Roman-Rice-Engineering/Pen_plotter_V2/custom_test.txt

[gwrite.my_own_plotter]
unit = "mm"
document_start = "M3 G21\n"
layer_start = "(Start Layer)\n"
line_start = "(Start Block)\n"
segment_first = """G00 X{x:.4f}f Y{y:.4f}
M3 S150
G4 P0.5
"""
segment = """G01 X{x:.4f} Y{y:.4f} F2500\n"""
line_end = """M5 S0
G4 P0.5\n"""
document_end = """M5
G00 X0.0000 Y0.0000
M2"""
invert_y = true

# from home
.local/pipx/venvs/vpype/lib/python3.10/site-packages/vpype_gcode/bundled_configs.toml

install pdftocairo
RUN wget --directory-prefix=~ poppler.freedesktop.org/poppler-22.04.0.tar.xz -O /tmp/poppler-22.04.0.tar.xz && apt-get install xz-utils && tar xf /tmp/poppler-22.04.0.tar.xz -C /tmp && cd /tmp/poppler-22.04.0 && ls && mkdir build && cd build && apt-get -y install libfreetype6-dev && apt-get -y install pkg-config && apt-get -y install libfontconfig1-dev && apt-get -y install libjpeg-dev && apt-get -y install libopenjp2-7-dev && apt-get -y install build-essential cmake && cmake -DENABLE_BOOST=OFF .. && make && make install 
pdftocairo -v
