Roman-Rice-Engineering/Pen_plotter_V2/PCB/Pen_Plotter_RPI_Hat_V2/3D_Models/CSTLS8M00G56-A0.step

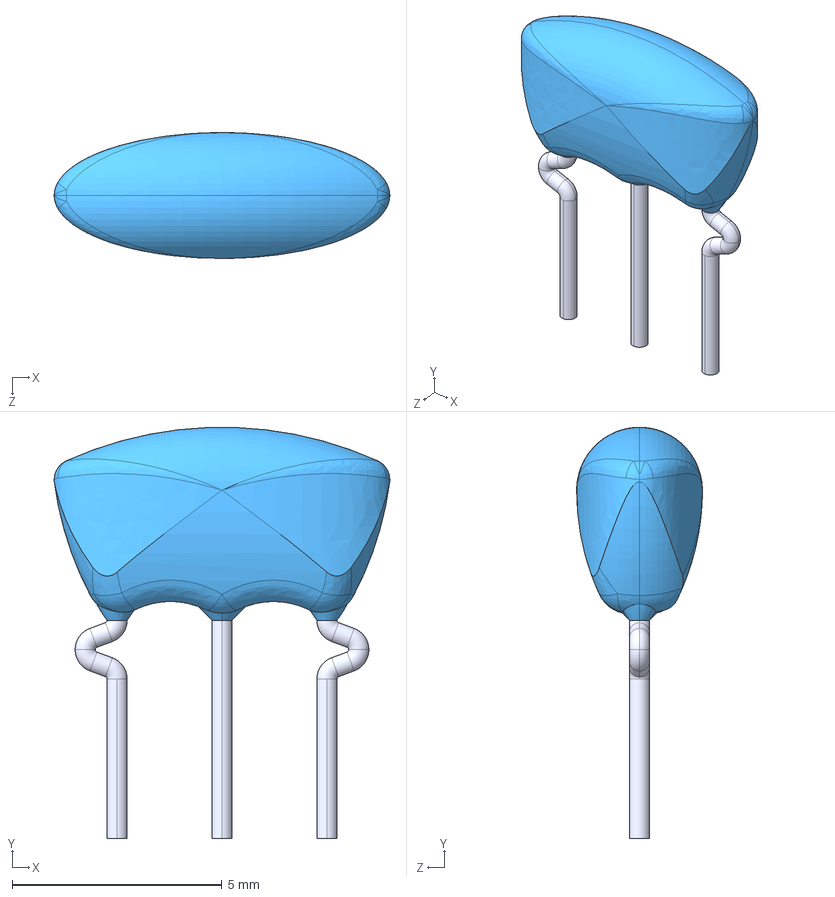
[picture p1: CAD file, 2024-05-06]
PCB/Pen_Plotter_RPI_Hat_V2/3D_Models/CSTLS8M00G56-A0.step
8.00 x 9.79 x 3.00 mm
