Roman-Rice-Engineering/Pen_plotter_V2/PCB/Pen_Plotter_RPI_Hat_V2/3D_Models/L-53GD--3DModel-STEP-510211.STEP

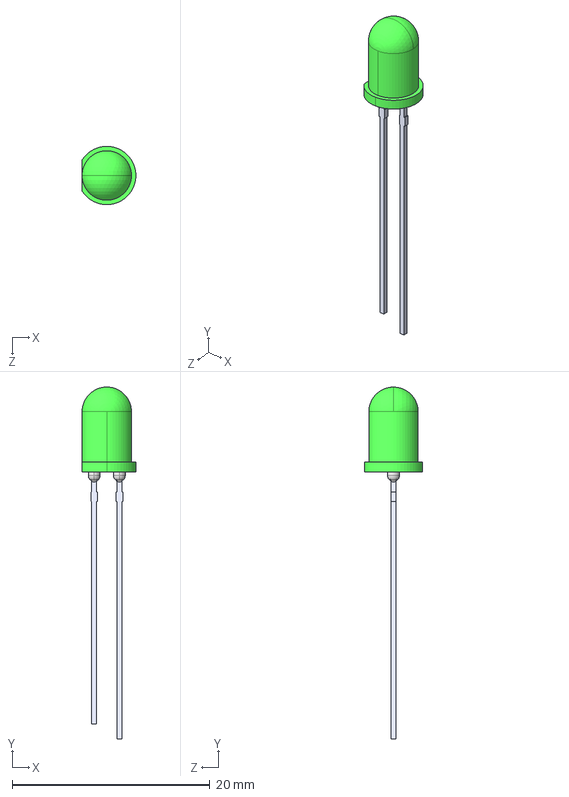
[picture p2: CAD file, 2024-01-29]
PCB/Pen_Plotter_RPI_Hat_V2/3D_Models/L-53GD--3DModel-STEP-510211.STEP
5.45 x 35.6 x 5.90 mm
