Roman-Rice-Engineering/Pen_plotter_V2/PCB/Pen_Plotter_RPI_Hat_V2/Pen_Plotter_RPI_Hat_V2.kicad_pcb

## KiCad design PCB/Pen_Plotter_RPI_Hat_V2/Pen_Plotter_RPI_Hat_V2.kicad_pcb (2024-05-07)

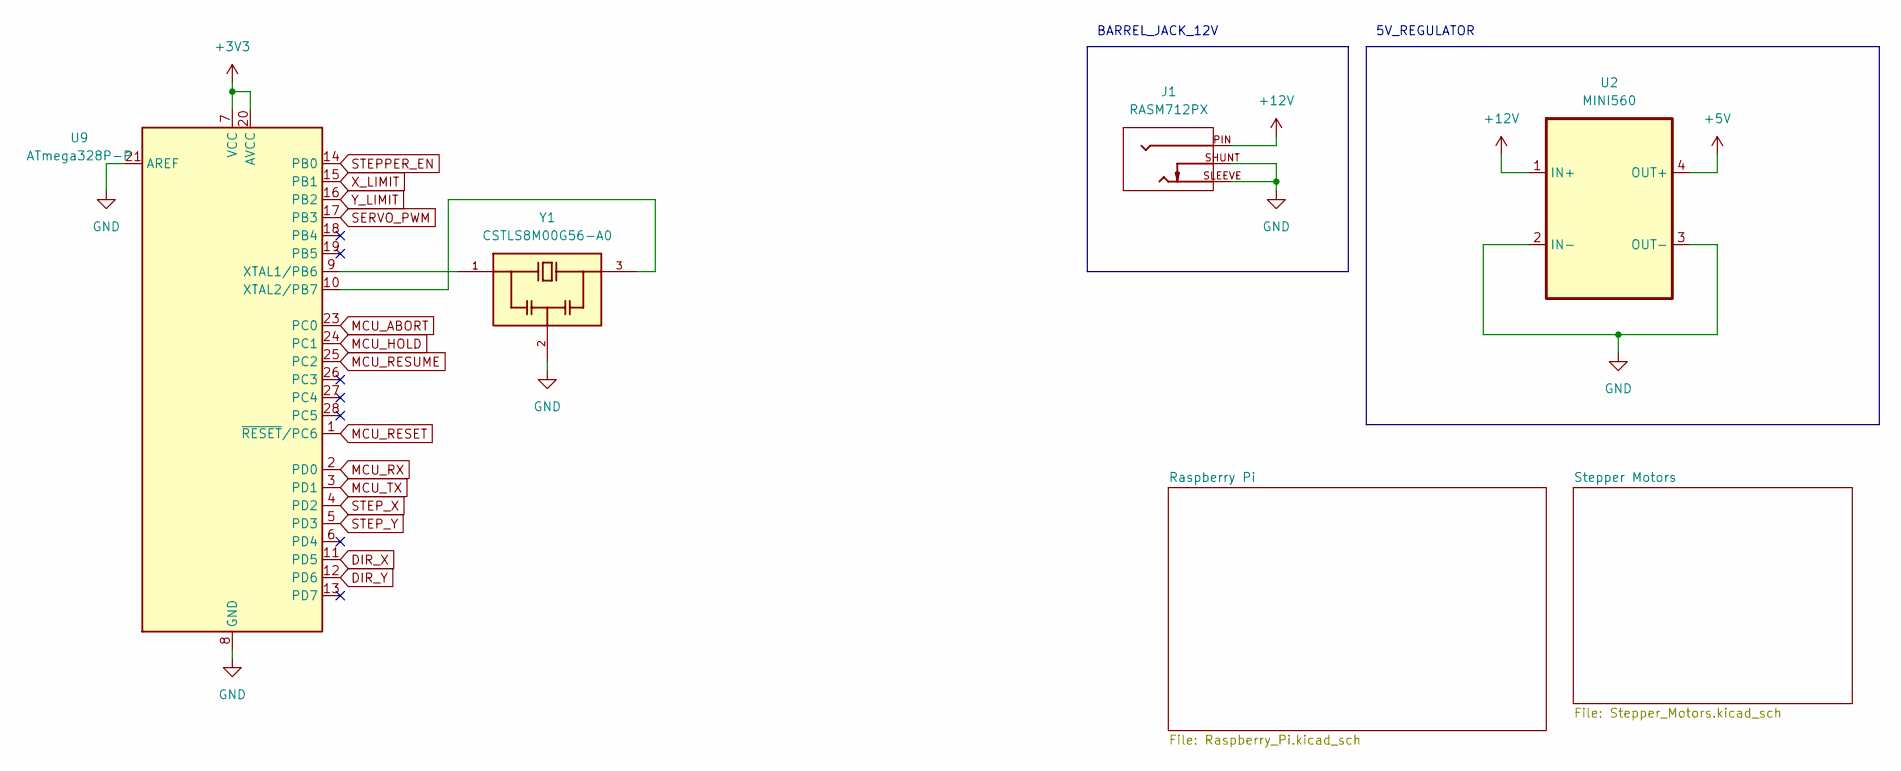
[picture p3: schematic Pen_Plotter_RPI_Hat_V2.kicad_sch]

Parts:
J1: RASM712PX; SWITCHCRAFT_RASM712PX; PARTREV A
U2: MINI560; MINI560_5V
U9: ATmega328P-P; DIP-28_W7.62mm
Y1: CSTLS8M00G56-A0; OSC_CSTLS8M00G56-A0; PARTREV March 23, 2017

Connections:
+3V3: U9.7 (VCC), U9.20 (AVCC); also elsewhere on the board
+5V: U2.4 (OUT+); also elsewhere on the board
+12V: J1.PIN, U2.1 (IN+); also elsewhere on the board
DIR_X: U9.11 (PD5); also elsewhere on the board
DIR_Y: U9.12 (PD6); also elsewhere on the board
GND: J1.SHUNT, J1.SLEEVE, U2.2 (IN-), U2.3 (OUT-), U9.8 (GND), U9.21 (AREF), U9.22 (GND), Y1.2; also elsewhere on the board
MCU_ABORT: U9.23 (PC0); also elsewhere on the board
MCU_HOLD: U9.24 (PC1); also elsewhere on the board
MCU_RESET: U9.1 (~RESET/PC6); also elsewhere on the board
MCU_RESUME: U9.25 (PC2); also elsewhere on the board
MCU_RX: U9.2 (PD0); also elsewhere on the board
MCU_TX: U9.3 (PD1); also elsewhere on the board
unnamed: U9.9 (XTAL1/PB6), Y1.1
unnamed: U9.10 (XTAL2/PB7), Y1.3
SERVO_PWM: U9.17 (PB3); also elsewhere on the board
STEPPER_EN: U9.14 (PB0); also elsewhere on the board
STEP_X: U9.4 (PD2); also elsewhere on the board
STEP_Y: U9.5 (PD3); also elsewhere on the board
X_LIMIT: U9.15 (PB1); also elsewhere on the board
Y_LIMIT: U9.16 (PB2); also elsewhere on the board

Notes on the sheet:
5V_REGULATOR
BARREL_JACK_12V

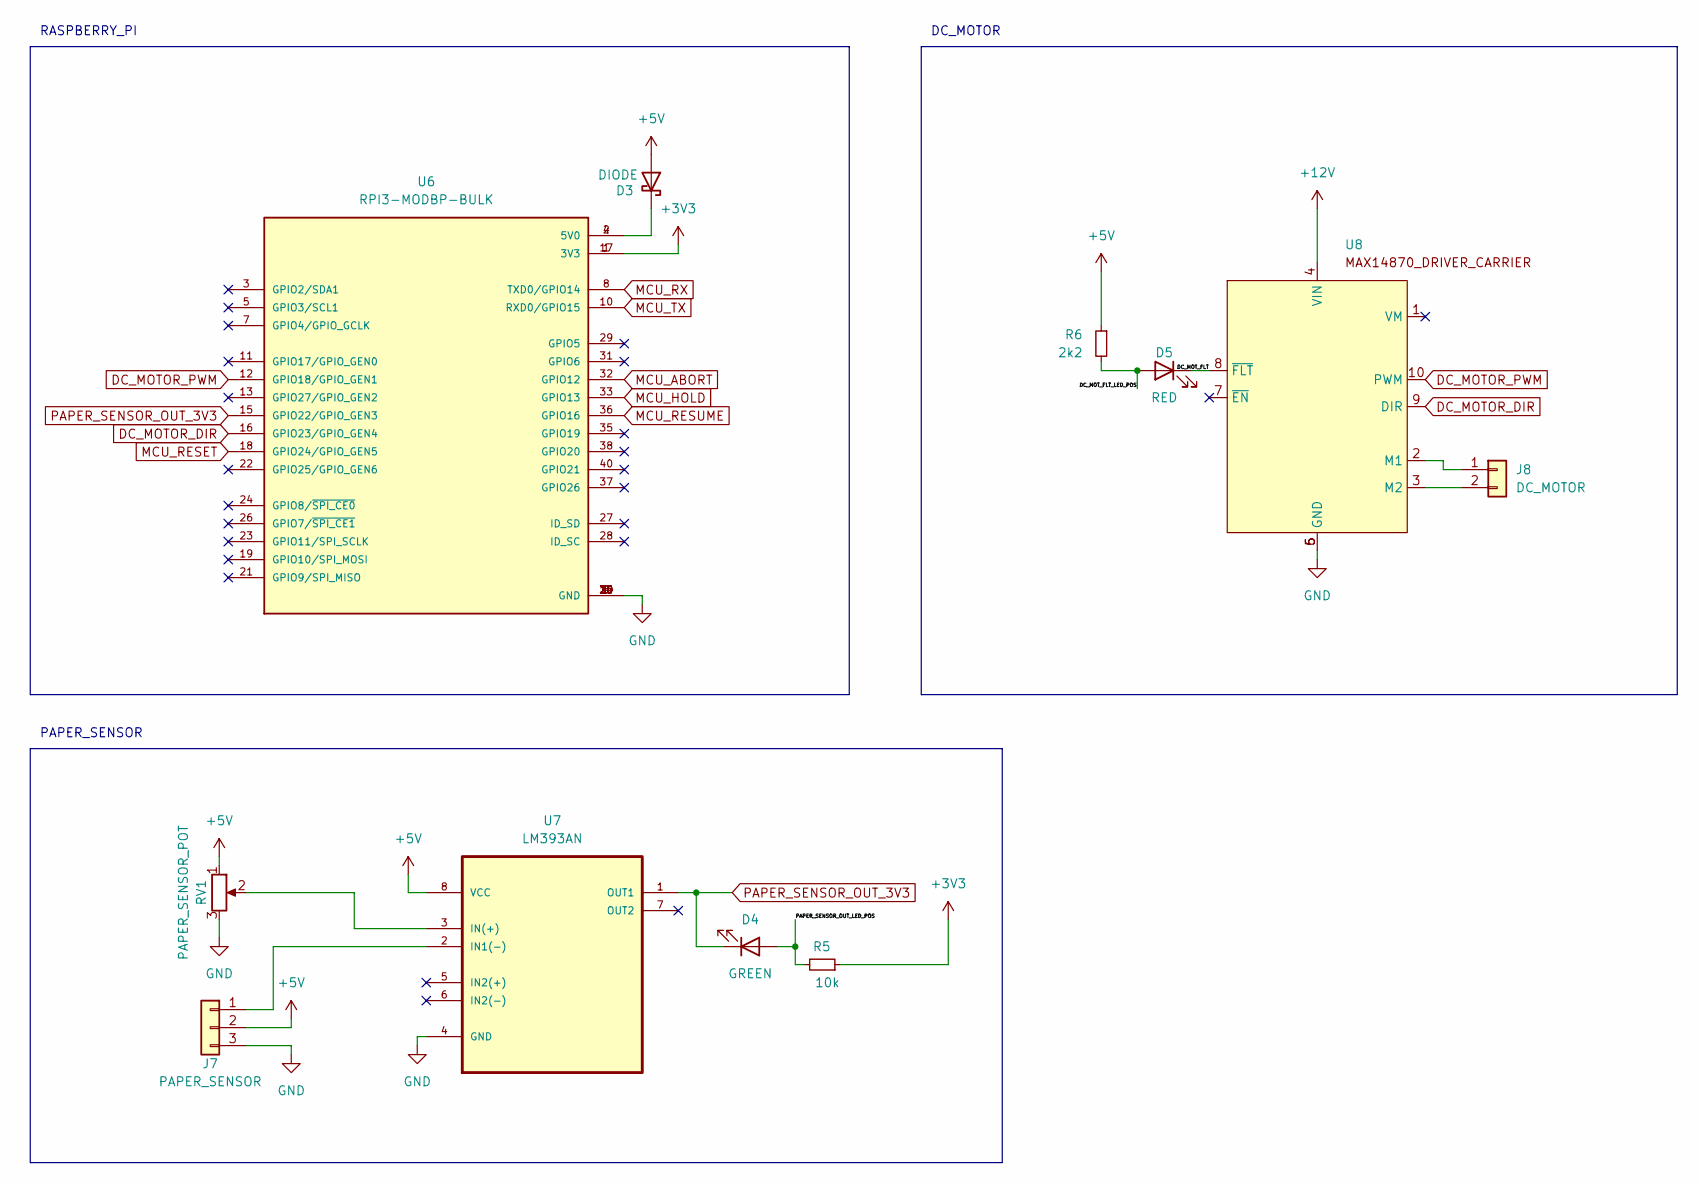
[picture p4: schematic Raspberry_Pi.kicad_sch]

Parts:
D3: DIODE; D_5W_P10.16mm_Horizontal
D4: GREEN; LED_D5.0mm
D5: RED; LED_D5.0mm
J7: PAPER_SENSOR; JST_EH_B3B-EH-A_1x03_P2.50mm_Vertical
J8: DC_MOTOR; JST_EH_B2B-EH-A_1x02_P2.50mm_Vertical
R5: 10k; THT_RESISTOR_WITH_VALUE
R6: 2k2; THT_RESISTOR_WITH_VALUE
RV1: PAPER_SENSOR_POT; Potentiometer_Bourns_3299W_Vertical
U6: RPI3-MODBP-BULK; MODULE_RPI3-MODBP-BULK; PARTREV 1.0
U7: LM393AN; DIP254P762X508-8; MPN LM393AN
U8: IC_MAX14870_DRIVER_CARRIER

Connections:
+3V3: R5.1, U6.1 (3V3), U6.17 (3V3); also elsewhere on the board
+5V: D3.2 (A), J7.2, R6.1, RV1.1, U7.8 (VCC); also elsewhere on the board
+12V: U8.4 (VIN); also elsewhere on the board
/Raspberry Pi/DC_MOT_FLT: D5.1 (K), U8.8 (~FLT)
/Raspberry Pi/DC_MOT_FLT_LED_POS: D5.2 (A), R6.2
/Raspberry Pi/PAPER_SENSOR_OUT_LED_POS: D4.2 (A), R5.2
DC_MOTOR_DIR: U6.16 (GPIO23/GPIO_GEN4), U8.9 (DIR)
DC_MOTOR_PWM: U6.12 (GPIO18/GPIO_GEN1), U8.10 (PWM)
GND: J7.3, RV1.3, U6.6 (GND), U6.9 (GND), U6.14 (GND), U6.20 (GND), U6.25 (GND), U6.30 (GND), U6.34 (GND), U6.39 (GND), U7.4 (GND), U8.5 (GND), U8.6 (GND); also elsewhere on the board
MCU_ABORT: U6.32 (GPIO12); also elsewhere on the board
MCU_HOLD: U6.33 (GPIO13); also elsewhere on the board
MCU_RESET: U6.18 (GPIO24/GPIO_GEN5); also elsewhere on the board
MCU_RESUME: U6.36 (GPIO16); also elsewhere on the board
MCU_RX: U6.8 (TXD0/GPIO14); also elsewhere on the board
MCU_TX: U6.10 (RXD0/GPIO15); also elsewhere on the board
unnamed: D3.1 (K), U6.2 (5V0), U6.4 (5V0)
unnamed: J7.1, U7.2 (IN1(-))
unnamed: J8.1, U8.2 (M1)
unnamed: J8.2, U8.3 (M2)
unnamed: RV1.2, U7.3 (IN(+))
PAPER_SENSOR_OUT_3V3: D4.1 (K), U6.15 (GPIO22/GPIO_GEN3), U7.1 (OUT1)

Notes on the sheet:
RASPBERRY_PI
PAPER_SENSOR
DC_MOTOR

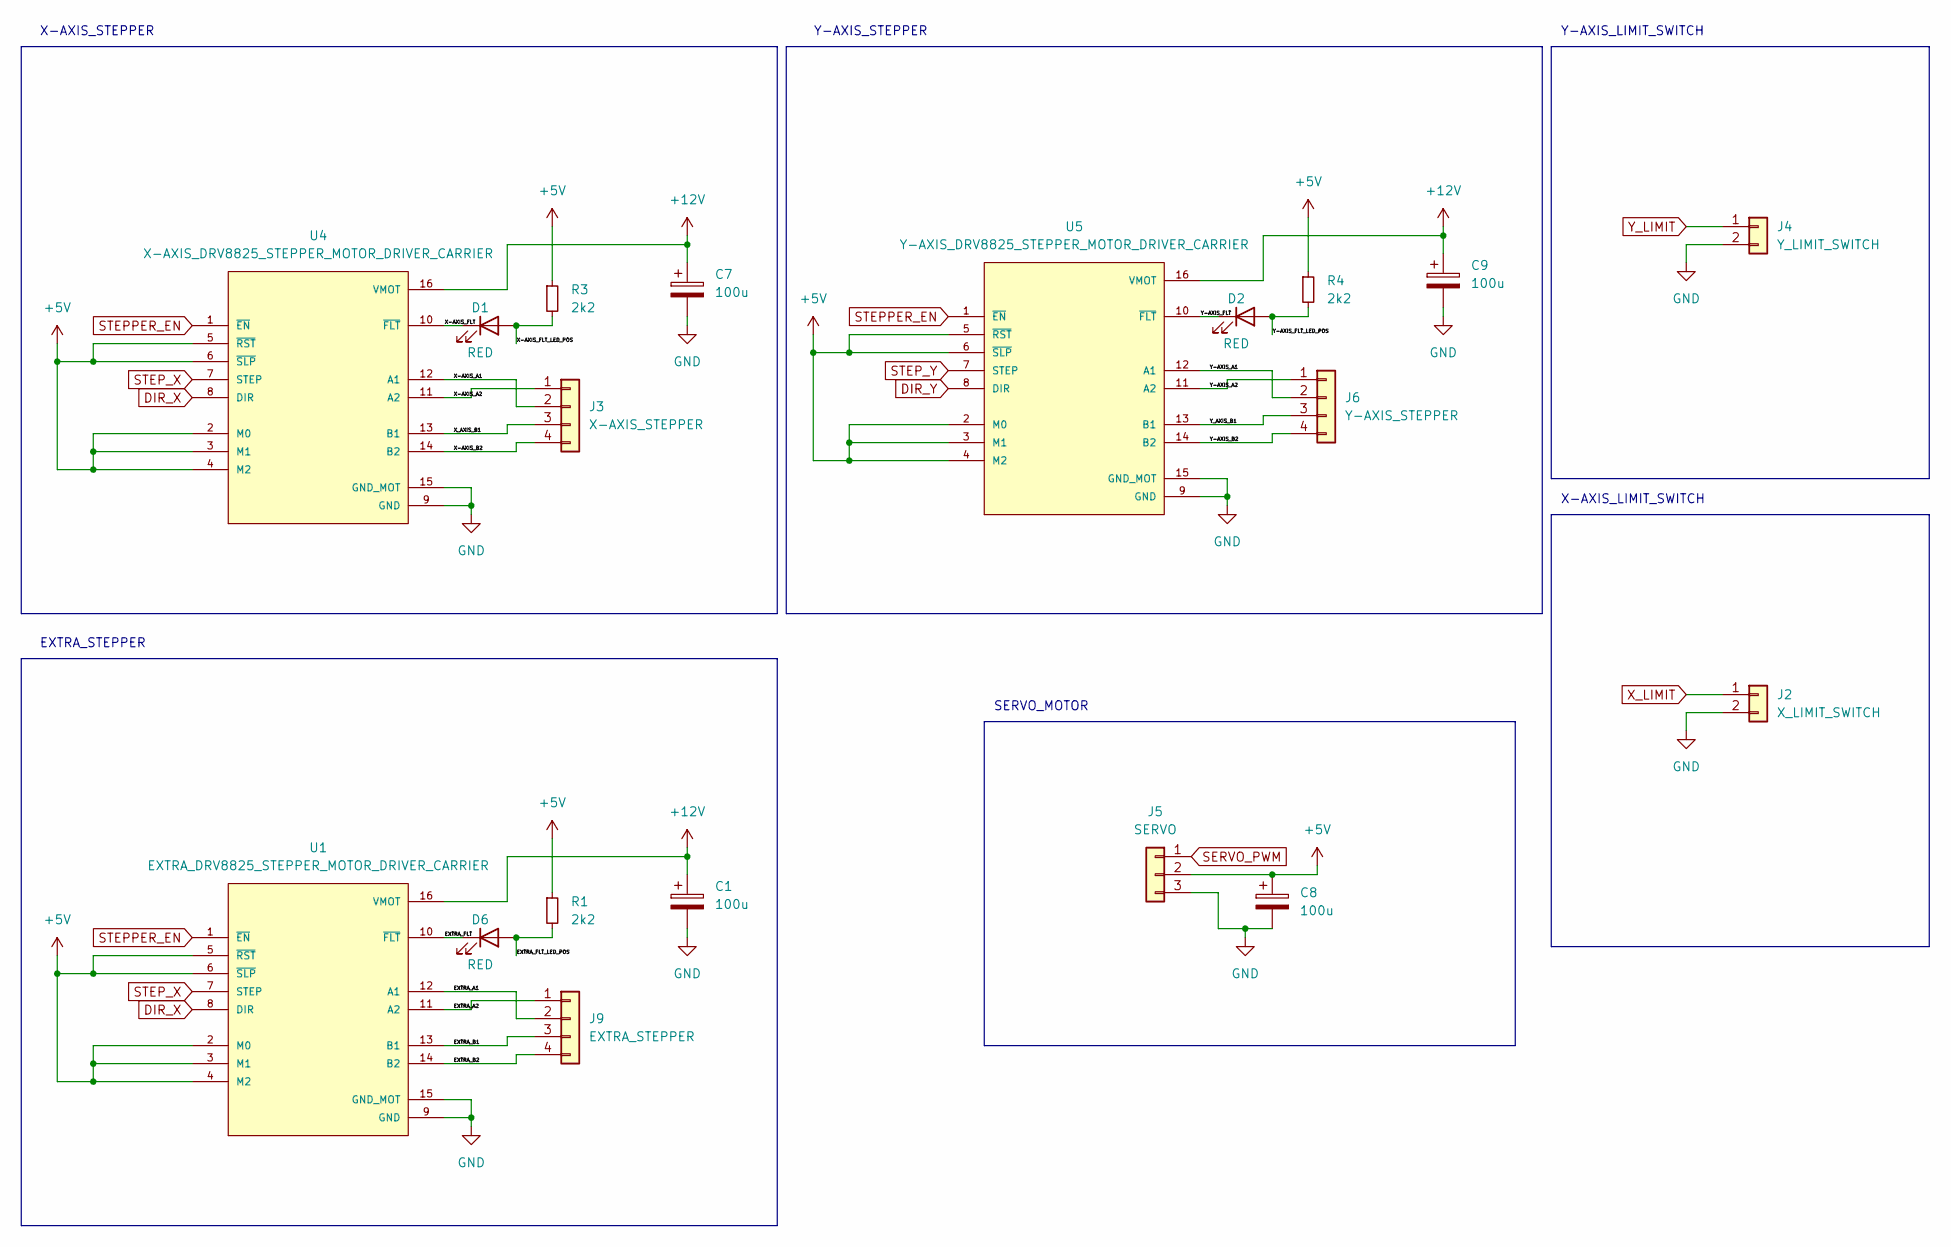
[picture p5: schematic Stepper_Motors.kicad_sch]

Parts:
C1, C7, C8, C9: 100u; CP_Radial_D6.3mm_P2.50mm
D1, D2, D6: RED; LED_D5.0mm
J2: X_LIMIT_SWITCH; JST_EH_B2B-EH-A_1x02_P2.50mm_Vertical
J3: X-AXIS_STEPPER; JST_EH_B4B-EH-A_1x04_P2.50mm_Vertical
J4: Y_LIMIT_SWITCH; JST_EH_B2B-EH-A_1x02_P2.50mm_Vertical
J5: SERVO; JST_EH_B3B-EH-A_1x03_P2.50mm_Vertical
J6: Y-AXIS_STEPPER; JST_EH_B4B-EH-A_1x04_P2.50mm_Vertical
J9: EXTRA_STEPPER; JST_EH_B4B-EH-A_1x04_P2.50mm_Vertical
R1, R3, R4: 2k2; THT_RESISTOR_WITH_VALUE
U1: EXTRA_DRV8825_STEPPER_MOTOR_DRIVER_CARRIER; IC_DRV8825_STEPPER_MOTOR_DRIVER_CARRIER
U4: X-AXIS_DRV8825_STEPPER_MOTOR_DRIVER_CARRIER; IC_DRV8825_STEPPER_MOTOR_DRIVER_CARRIER
U5: Y-AXIS_DRV8825_STEPPER_MOTOR_DRIVER_CARRIER; IC_DRV8825_STEPPER_MOTOR_DRIVER_CARRIER

Connections:
+5V: C8.1, J5.2, R1.1, R3.1, R4.1, U1.2 (M0), U1.3 (M1), U1.4 (M2), U1.5 (~RST), U1.6 (~SLP), U4.2 (M0), U4.3 (M1), U4.4 (M2), U4.5 (~RST), U4.6 (~SLP), U5.2 (M0), U5.3 (M1), U5.4 (M2), U5.5 (~RST), U5.6 (~SLP); also elsewhere on the board
+12V: C1.1, C7.1, C9.1, U1.16 (VMOT), U4.16 (VMOT), U5.16 (VMOT); also elsewhere on the board
/Stepper Motors/EXTRA_A1: J9.2, U1.12 (A1)
/Stepper Motors/EXTRA_A2: J9.1, U1.11 (A2)
/Stepper Motors/EXTRA_B1: J9.3, U1.13 (B1)
/Stepper Motors/EXTRA_B2: J9.4, U1.14 (B2)
/Stepper Motors/EXTRA_FLT: D6.1 (K), U1.10 (~FLT)
/Stepper Motors/EXTRA_FLT_LED_POS: D6.2 (A), R1.2
/Stepper Motors/X-AXIS_A1: J3.2, U4.12 (A1)
/Stepper Motors/X-AXIS_A2: J3.1, U4.11 (A2)
/Stepper Motors/X-AXIS_B2: J3.4, U4.14 (B2)
/Stepper Motors/X-AXIS_FLT: D1.1 (K), U4.10 (~FLT)
/Stepper Motors/X-AXIS_FLT_LED_POS: D1.2 (A), R3.2
/Stepper Motors/X_AXIS_B1: J3.3, U4.13 (B1)
/Stepper Motors/Y-AXIS_A1: J6.2, U5.12 (A1)
/Stepper Motors/Y-AXIS_A2: J6.1, U5.11 (A2)
/Stepper Motors/Y-AXIS_B2: J6.4, U5.14 (B2)
/Stepper Motors/Y-AXIS_FLT: D2.1 (K), U5.10 (~FLT)
/Stepper Motors/Y-AXIS_FLT_LED_POS: D2.2 (A), R4.2
/Stepper Motors/Y_AXIS_B1: J6.3, U5.13 (B1)
DIR_X: U1.8 (DIR), U4.8 (DIR); also elsewhere on the board
DIR_Y: U5.8 (DIR); also elsewhere on the board
GND: C1.2, C7.2, C8.2, C9.2, J2.2, J4.2, J5.3, U1.9 (GND), U1.15 (GND_MOT), U4.9 (GND), U4.15 (GND_MOT), U5.9 (GND), U5.15 (GND_MOT); also elsewhere on the board
SERVO_PWM: J5.1; also elsewhere on the board
STEPPER_EN: U1.1 (~EN), U4.1 (~EN), U5.1 (~EN); also elsewhere on the board
STEP_X: U1.7 (STEP), U4.7 (STEP); also elsewhere on the board
STEP_Y: U5.7 (STEP); also elsewhere on the board
X_LIMIT: J2.1; also elsewhere on the board
Y_LIMIT: J4.1; also elsewhere on the board

Notes on the sheet:
Y-AXIS_LIMIT_SWITCH
EXTRA_STEPPER
SERVO_MOTOR
X-AXIS_STEPPER
X-AXIS_LIMIT_SWITCH
Y-AXIS_STEPPER

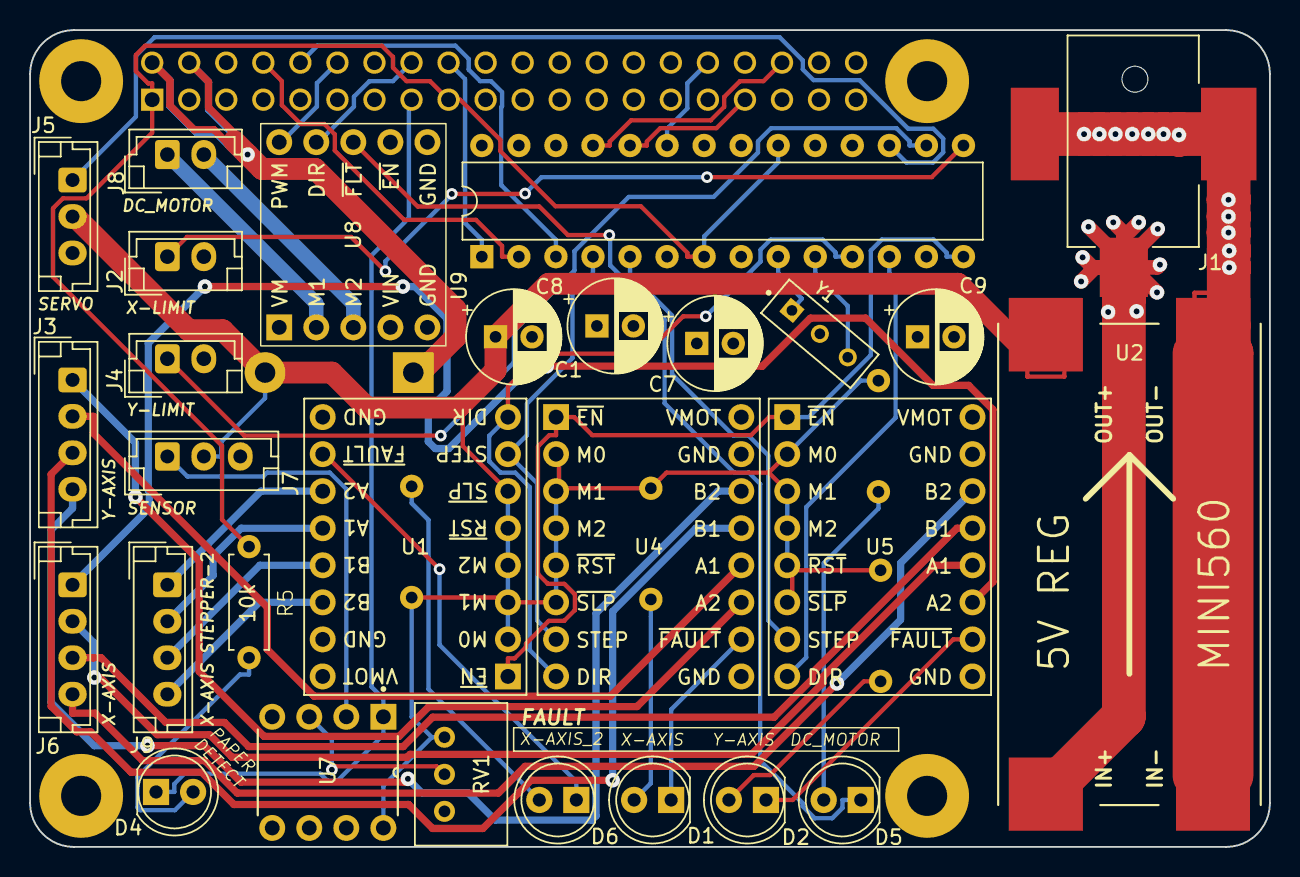
[picture p6: board Pen_Plotter_RPI_Hat_V2.kicad_pcb from above]

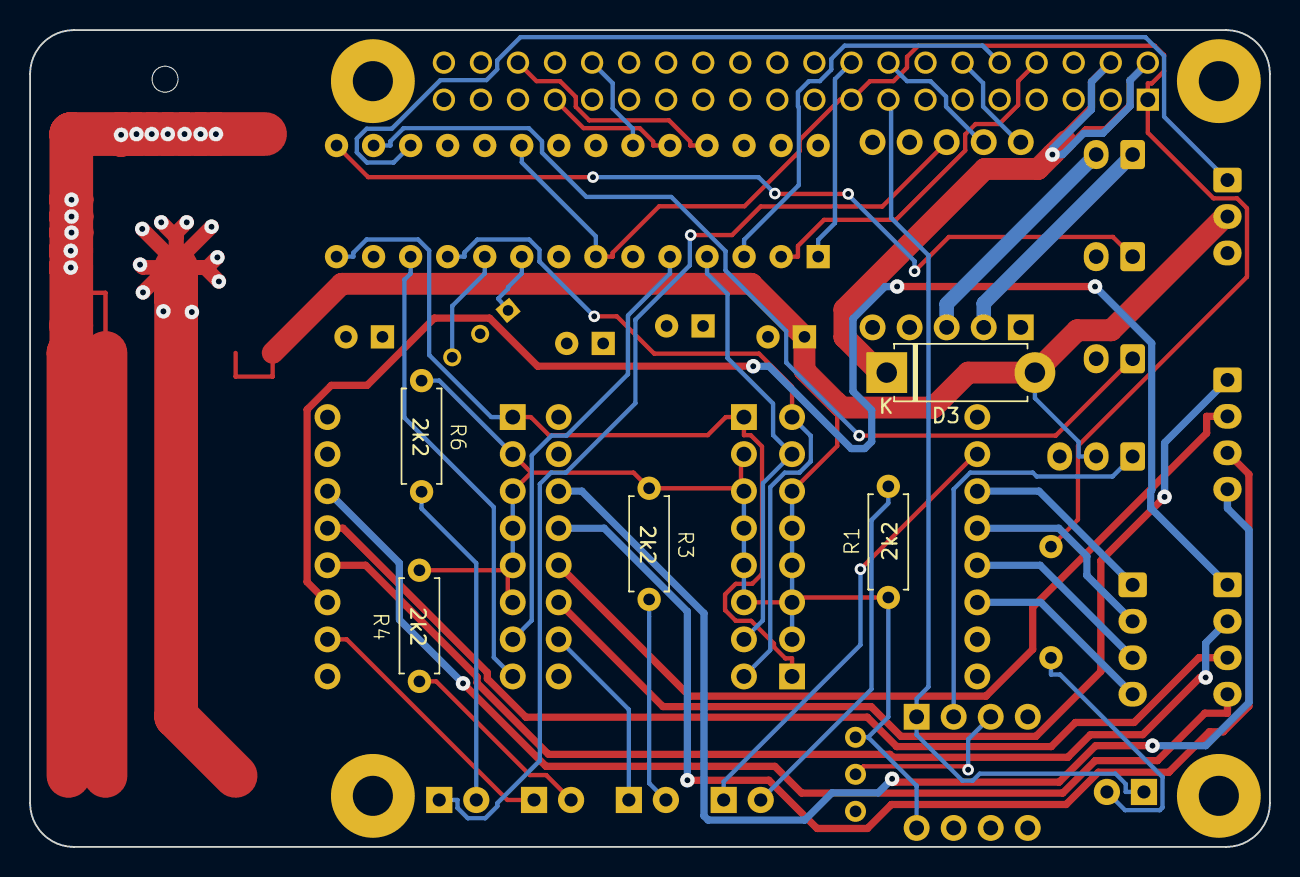
[picture p7: board Pen_Plotter_RPI_Hat_V2.kicad_pcb from below]

Board: 4 copper layers, 85.0 x 56.0 mm, 34 parts (5 on the bottom side), 49 nets.
