Roman-Rice-Engineering/Pen_plotter_V2/(commit log)

2024-01-18 fixed vpype config not updating and added pdftocairo installer
    [main.py]
2024-01-29 Started RPI hat PCB
    [DC_And_Servo.kicad_sch, L-53GD--3DModel-STEP-510211.STEP, Pen_Plotter_RPI_Hat_V2.kicad_pcb, Pen_Plotter_RPI_Hat_V2.kicad_sch, Power_Supply.kicad_sch, Raspberry_Pi.kicad_sch, Stepper_Motors.kicad_sch, USB.kicad_sch]
2024-01-30 Simplified design, began layout process
    [CSTLS16M0X55-A0.step, Pen_Plotter_RPI_Hat_V2.kicad_pcb, Pen_Plotter_RPI_Hat_V2.kicad_sch, Power_Supply.kicad_sch, Raspberry_Pi.kicad_sch, Stepper_Motors.kicad_sch, USB.kicad_sch]
2024-01-31 Completed PCB component layout, routing and silkscreen work is still needed
    [Pen_Plotter_RPI_Hat_V2.kicad_pcb, Raspberry_Pi.kicad_sch]
2024-02-01 Completed PCB layout, started routing
    [Pen_Plotter_RPI_Hat_V2.kicad_pcb, Pen_Plotter_RPI_Hat_V2.kicad_sch]
2024-02-01 Completed PCB routing, working on resolving final DRC errors
    [Pen_Plotter_RPI_Hat_V2.kicad_pcb]
2024-02-01 Completed PCB
    [Pen_Plotter_RPI_Hat_V2.kicad_pcb]
2024-03-19 Fixed converter footprint
    Corrected dimensions and removed THT to prevent short when connected to RPI
2024-03-19 Made PCB use new model for MINI560
    [Pen_Plotter_RPI_Hat_V2.kicad_pcb]
2024-03-19 Started work on fixing last few problems
    [Pen_Plotter_RPI_Hat_V2.kicad_pcb]
2024-04-02 Started work on converting to atmega328p control circuit
    [Pen_Plotter_RPI_Hat_V2.kicad_pcb, Pen_Plotter_RPI_Hat_V2.kicad_sch, Raspberry_Pi.kicad_sch]
2024-04-02 Added third stepper motor driver
    [Pen_Plotter_RPI_Hat_V2.kicad_pcb, Pen_Plotter_RPI_Hat_V2.kicad_sch, Stepper_Motors.kicad_sch]
2024-05-06 Replaced 16Mhz crystal in library with 8Mhz crystal
    [CSTLS16M0X55-A0.step, CSTLS8M00G56-A0.step]
2024-05-06 Completed PCB layout
    [Pen_Plotter_RPI_Hat_V2.kicad_pcb, Pen_Plotter_RPI_Hat_V2.kicad_sch]
2024-05-07 Manually added traces for high current
    [Pen_Plotter_RPI_Hat_V2.kicad_pcb]
2024-05-07 Changed layout and footprints to make routing easier
    [Pen_Plotter_RPI_Hat_V2.kicad_pcb]
2024-05-07 Completed routing of circuit board
    [Pen_Plotter_RPI_Hat_V2.kicad_pcb]
